HearnChristian/atmos-sense/README.md

# atmos-sense
Summer 2026 project to build familiarity with atmospheric sensor systems, drone integration, and all necessary concepts.
