HearnChristian/atmos-sense/firmware/ai/Atmos.pdf

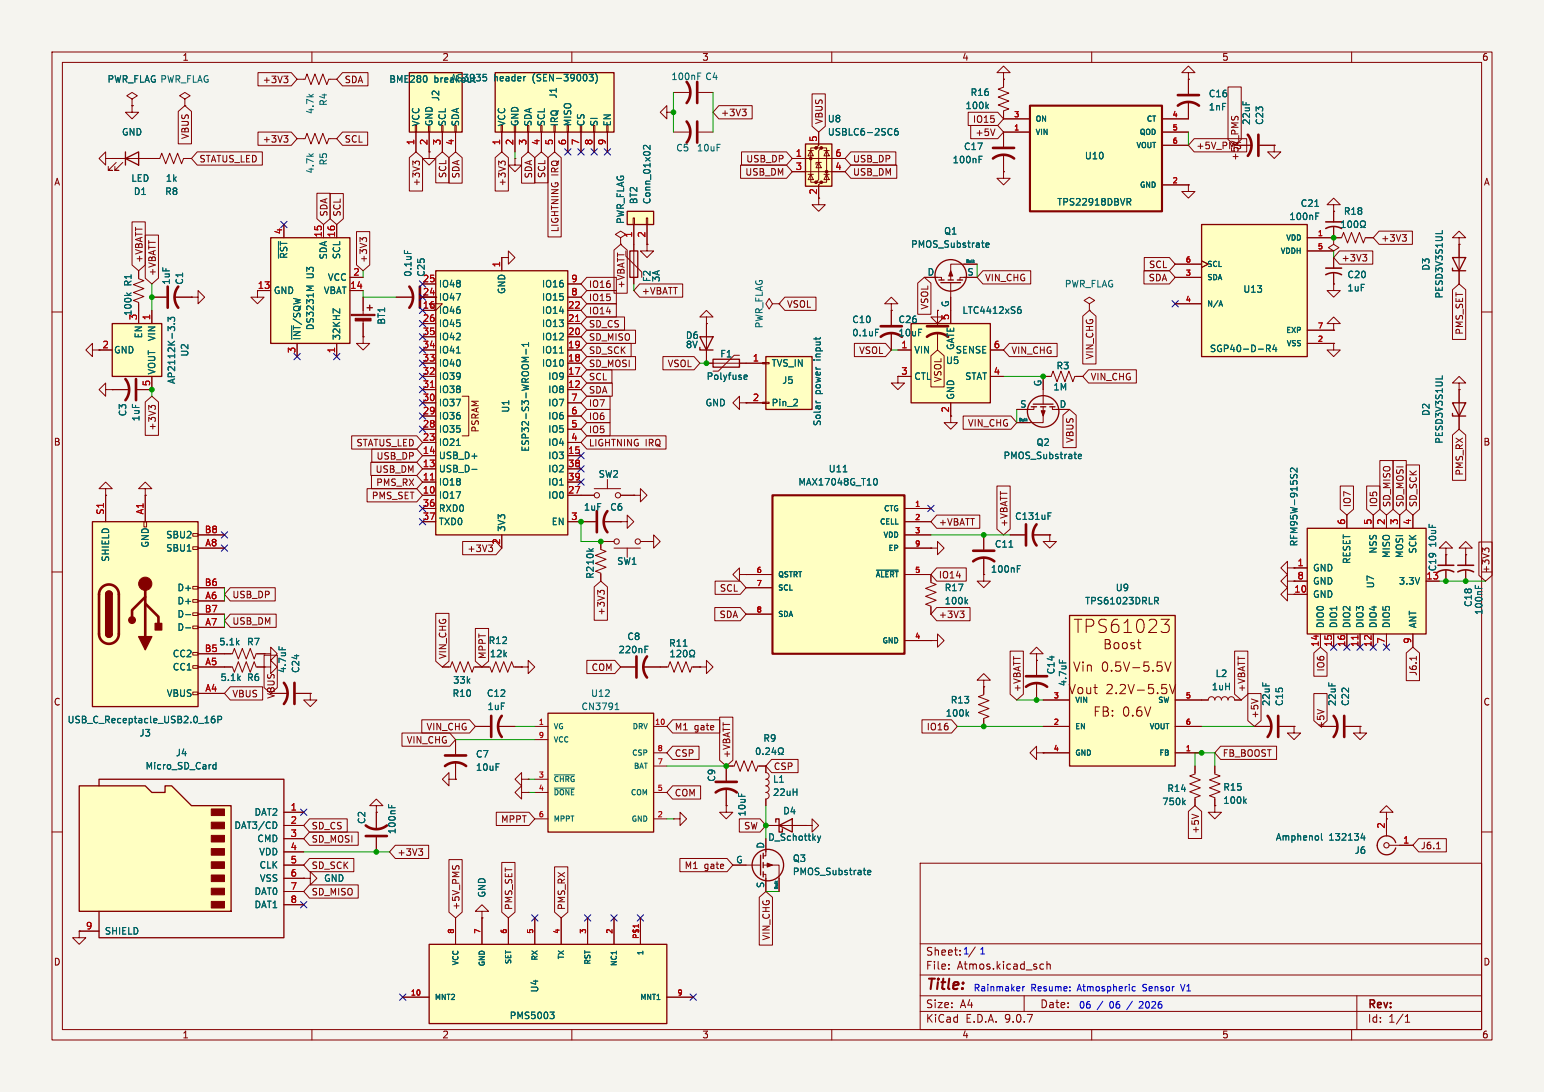
[picture p1: page 1]

Id: 1/1 Title: File: Atmos.kicad_sch Sheet: / C7
