HearnChristian/atmos-sense/firmware/ai/Atmos-pcb-routed.pdf

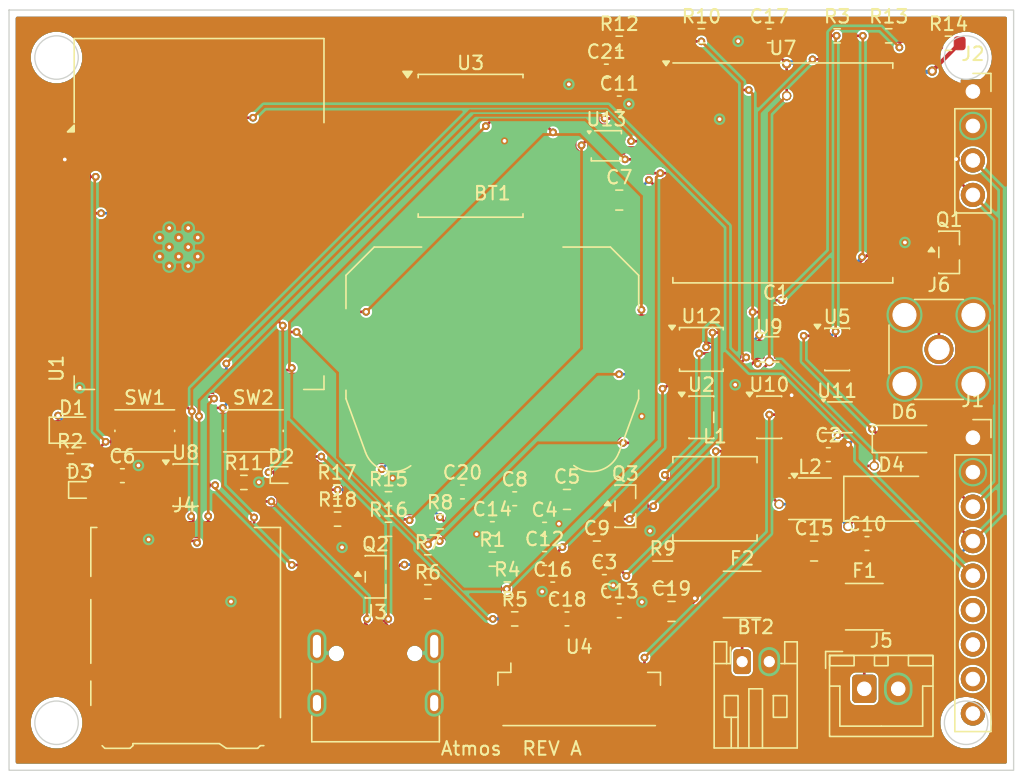
[picture p2: page 1]
