HearnChristian/atmos-sense/firmware/Atmos.kicad_pcb

## KiCad design firmware/Atmos.kicad_pcb (2026-07-20)

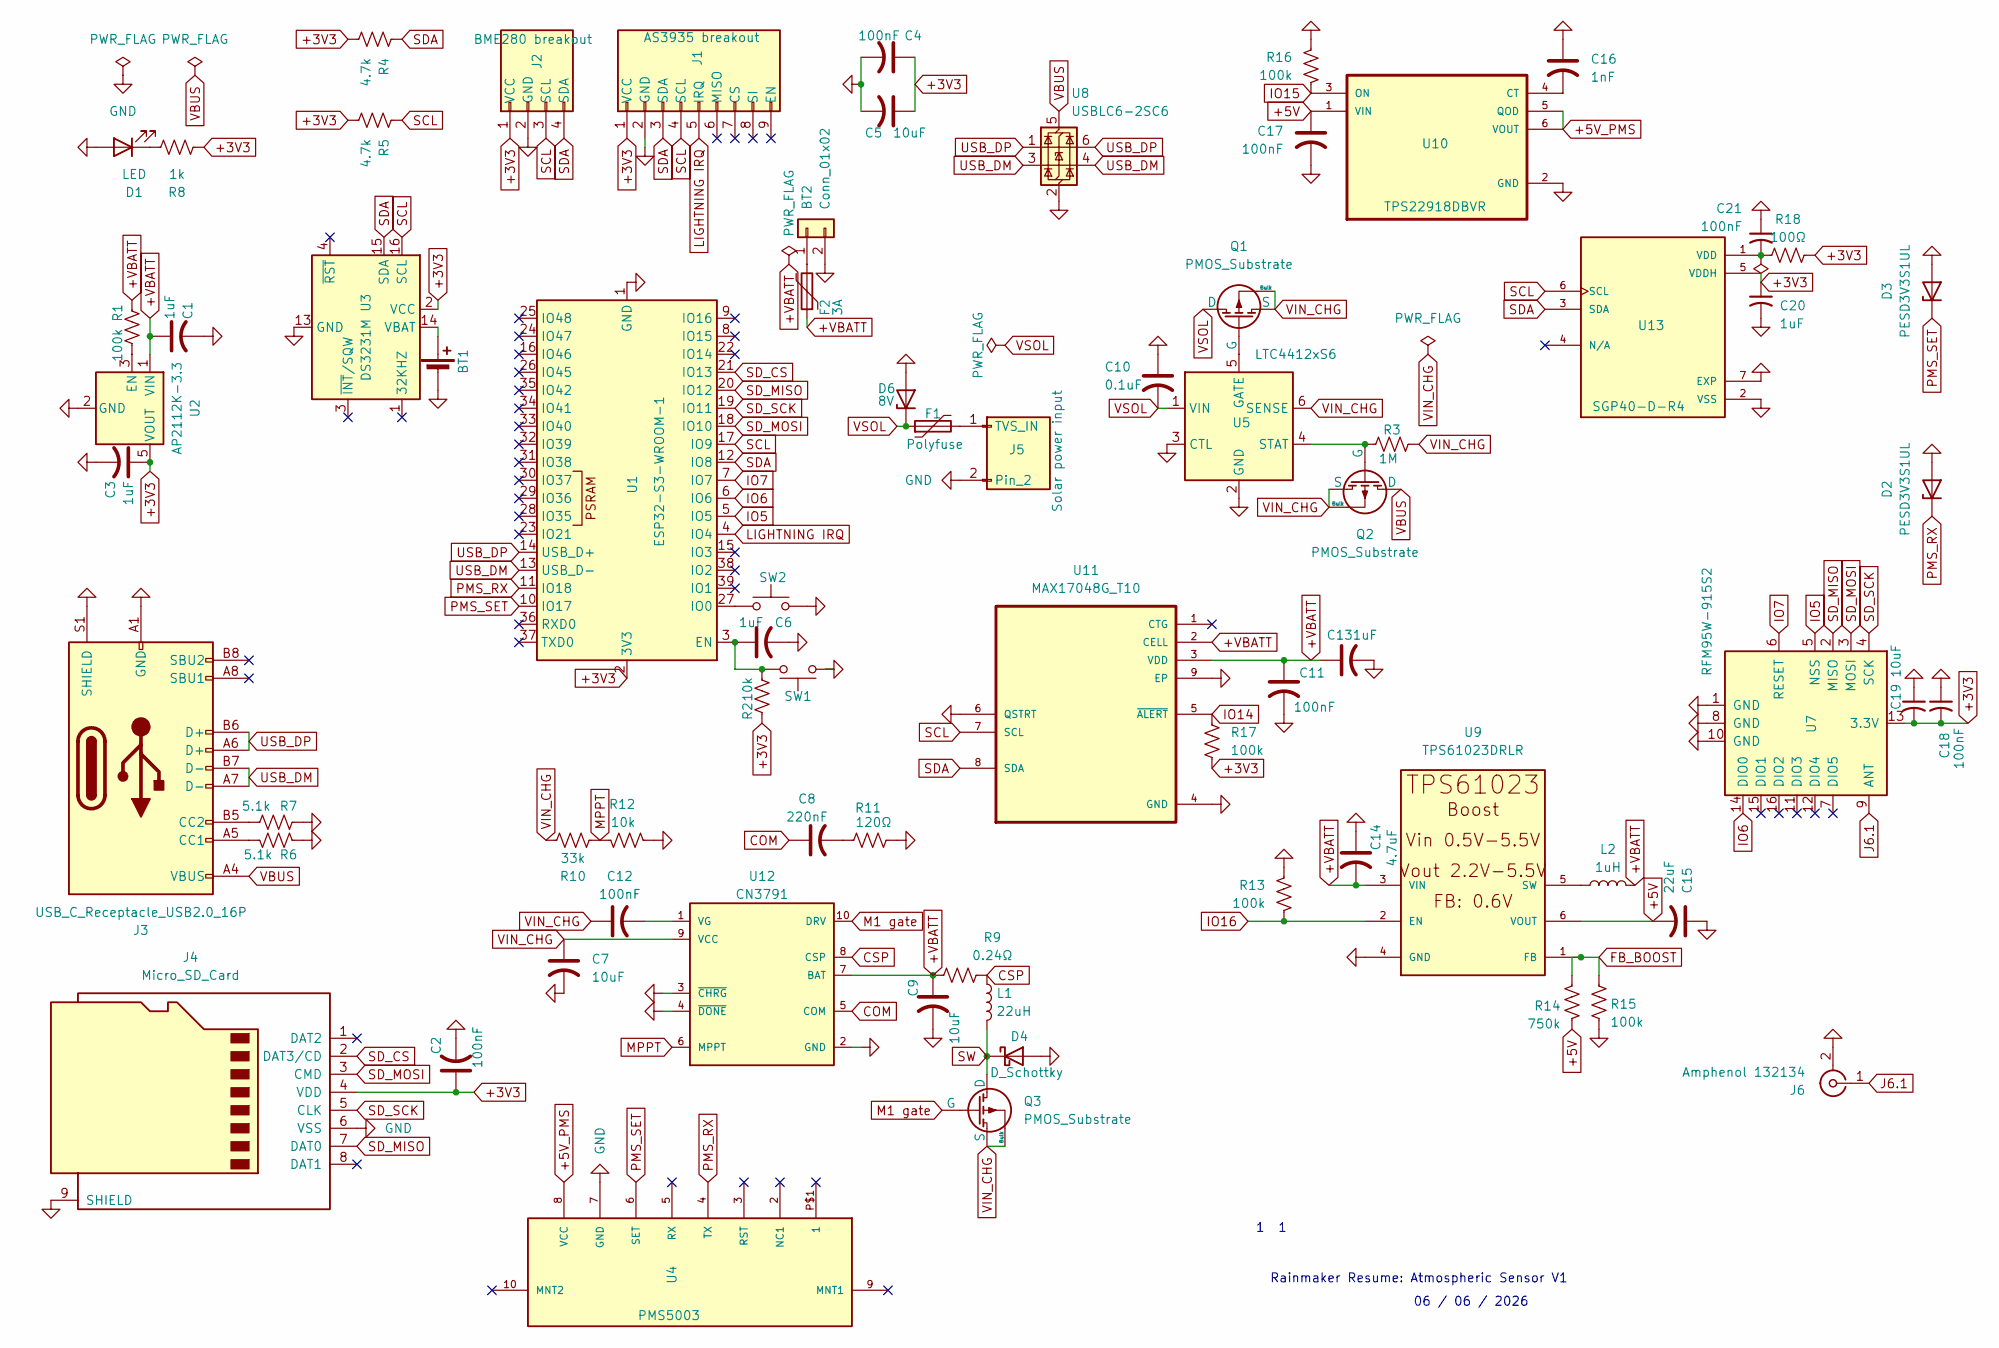
[picture p3: schematic Atmos.kicad_sch]

Parts:
BT1: Battery_Cell; BatteryHolder_Keystone_3034_1x20mm
BT2: Conn_01x02; JST_PH_S2B-PH-K_1x02_P2.00mm_Horizontal
C1, C3, C6, C13, C20: 1uF; C_0603_1608Metric
C2, C4, C11, C12, C17, C18, C21: 100nF; C_0603_1608Metric
C5, C7, C9, C19: 10uF; C_0805_2012Metric
C8: 220nF; C_0603_1608Metric
C10: 0.1uF; C_0603_1608Metric
C14: 4.7uF; C_0603_1608Metric
C15: 22uF; C_0805_2012Metric
C16: 1nF; C_0603_1608Metric
D1: LED; LED_0805_2012Metric
D2, D3: PESD3V3S1UL; D_SOD-882
D4: D_Schottky; D_SMA
D6: 8V; D_SOD-123
F1: Polyfuse; Fuse_1812_4532Metric
F2: 3A; Fuse_1812_4532Metric
J1: AS3935 breakout; PinSocket_1x09_P2.54mm_Vertical
J2: BME280 breakout; PinSocket_1x04_P2.54mm_Vertical
J3: USB_C_Receptacle_USB2.0_16P; USB_C_Receptacle_HRO_TYPE-C-31-M-12
J4: Micro_SD_Card; microSD_HC_Hirose_DM3AT-SF-PEJM5
J5: Solar power input; JST_XH_B2B-XH-A_1x02_P2.50mm_Vertical
J6: Amphenol 132134; SMA_Amphenol_132134_Vertical
L1: 22uH; L_Bourns_SRN6045TA
L2: 1uH; L_Coilcraft_1008HQ_2520Metric
Q1, Q2, Q3: PMOS_Substrate; SOT-23
R1, R13, R15, R16, R17: 100k; R_0603_1608Metric
R2, R12: 10k; R_0603_1608Metric
R3: 1M; R_0603_1608Metric
R4, R5: 4.7k; R_0603_1608Metric
R6, R7: 5.1k; R_0603_1608Metric
R8: 1k; R_0603_1608Metric
R9: 0.24Ω; R_1206_3216Metric
R10: 33k; R_0603_1608Metric
R11: 120Ω; R_0603_1608Metric
R14: 750k; R_0603_1608Metric
R18: 100Ω; R_0603_1608Metric
SW1: SW_Push_1P1T_NO_CK_KMR2
SW2: SW_Push; SW_Push_1P1T_NO_CK_KMR2
U1: ESP32-S3-WROOM-1
U2: AP2112K-3.3; SOT-23-5
U3: DS3231M; SOIC-16W_7.5x10.3mm_P1.27mm
U4: PMS5003; Molex_PicoBlade_53398-0871_1x08-1MP_P1.25mm_Vertical
U5: LTC4412xS6; TSOT-23-6
U7: RFM95W-915S2; HOPERF_RFM9XW_SMD
U8: USBLC6-2SC6; SOT-23-6
U9: TPS61023DRLR; SOT-563
U10: TPS22918DBVR; SOT-23-6
U11: MAX17048G_T10; DFN-8-1EP_2x2mm_P0.5mm_EP0.9x1.5mm
U12: CN3791; MSOP-10_3x3mm_P0.5mm
U13: SGP40-D-R4; DFN-6-1EP_2x2mm_P0.5mm_EP0.7x1.6mm; PARTREV 1.2

Connections:
+3V3: C2.1, C3.1, C4.1, C5.1, C18.2, C19.2, C20.1, J1.1 (VCC), J2.1 (VCC), J4.4 (VDD), R2.2, R4.2, R5.2, R8.1, R17.2, R18.2, U1.2 (3V3), U2.5 (VOUT), U3.2 (VCC), U7.13 (3.3V), U13.5 (VDDH)
+5V: C15.2, C17.1, R14.2, U9.6 (VOUT), U10.1 (VIN)
+5V_PMS: U4.8 (VCC), U10.5 (QOD), U10.6 (VOUT)
+VBATT: C1.1, C9.1, C11.1, C13.1, C14.2, F2.1, L2.2, R1.1, R9.1, U2.1 (VIN), U9.3 (VIN), U11.2 (CELL), U11.3 (VDD), U12.7 (BAT)
COM: C8.1, U12.5 (COM)
CSP: L1.1, R9.2, U12.8 (CSP)
FB_BOOST: R14.1, R15.1, U9.1 (FB)
GND: BT1.2 (-), BT2.2, C1.2, C2.2, C3.2, C4.2, C5.2, C6.2, C7.2, C9.2, C10.1, C11.2, C13.2, C14.1, C15.1, C16.1, C17.2, C18.1, C19.1, C20.2, C21.1, D1.2 (A), D2.2 (A), D3.2 (A), D4.2 (A), D6.2 (A), J1.2 (GND), J2.2 (GND), J3.A1 (GND), J3.A12 (GND), J3.B1 (GND), J3.B12 (GND), J3.S1 (SHIELD), J4.6 (VSS), J4.9 (SHIELD), J5.2, J6.2 (Ext), R6.2, R7.2, R11.2, R12.2, R13.1, R15.2, R16.1, SW1.1, SW2.2, U1.1 (GND), U1.40 (GND), U1.41 (GND), U2.2 (GND), U3.5 (GND), U3.6 (GND), U3.7 (GND), U3.8 (GND), U3.9 (GND), U3.10 (GND), U3.11 (GND), U3.12 (GND), U3.13 (GND), U4.7 (GND), U5.2 (GND), U5.3 (CTL), U7.1 (GND), U7.8 (GND), U7.10 (GND), U8.2 (GND), U9.4 (GND), U10.2 (GND), U11.4 (GND), U11.6 (QSTRT), U11.9 (EP), U12.2 (GND), U12.3 (~CHRG), U12.4 (~DONE), U13.2 (VSS), U13.7 (EXP)
IO5: U1.5 (IO5), U7.5 (NSS)
IO6: U1.6 (IO6), U7.14 (DIO0)
IO7: U1.7 (IO7), U7.6 (RESET)
IO14: R17.1, U11.5 (~ALERT)
IO15: R16.2, U10.3 (ON)
IO16: R13.2, U9.2 (EN)
J6.1: J6.1 (In), U7.9 (ANT)
LIGHTNING IRQ: J1.5 (IRQ), U1.4 (IO4)
M1 gate: Q3.2 (G), U12.10 (DRV)
MPPT: R10.1, R12.1, U12.6 (MPPT)
unnamed: BT1.1 (+), U3.14 (VBAT)
unnamed: BT2.1, F2.2
unnamed: C8.2, R11.1
unnamed: D1.1 (K), R8.2
unnamed: J3.A5 (CC1), R6.1
unnamed: J3.B5 (CC2), R7.1
unnamed: F1.2, J5.1 (TVS_IN)
unnamed: Q1.2 (G), U5.5 (GATE)
unnamed: Q2.2 (G), R3.1, U5.4 (STAT)
unnamed: C6.1, R2.1, SW1.2, U1.3 (EN)
unnamed: SW2.1, U1.27 (IO0)
unnamed: R1.2, U2.3 (EN)
unnamed: L2.1, U9.5 (SW)
unnamed: C16.2, U10.4 (CT)
unnamed: C12.2, U12.1 (VG)
unnamed: C21.2, R18.1, U13.1 (VDD)
PMS_RX: D2.1 (K), U1.11 (IO18), U4.4 (TX)
PMS_SET: D3.1 (K), U1.10 (IO17), U4.6 (SET)
SCL: J1.4 (SCL), J2.3 (SCL), R5.1, U1.17 (IO9), U3.16 (SCL), U11.7 (SCL), U13.6 (SCL)
SDA: J1.3 (SDA), J2.4 (SDA), R4.1, U1.12 (IO8), U3.15 (SDA), U11.8 (SDA), U13.3 (SDA)
SD_CS: J4.2 (DAT3/CD), U1.21 (IO13)
SD_MISO: J4.7 (DAT0), U1.20 (IO12), U7.2 (MISO)
SD_MOSI: J4.3 (CMD), U1.18 (IO10), U7.3 (MOSI)
SD_SCK: J4.5 (CLK), U1.19 (IO11), U7.4 (SCK)
SW: D4.1 (K), L1.2, Q3.1 (D)
USB_DM: J3.A7 (D-), J3.B7 (D-), U1.13 (USB_D-), U8.3 (I/O2), U8.4 (I/O2)
USB_DP: J3.A6 (D+), J3.B6 (D+), U1.14 (USB_D+), U8.1 (I/O1), U8.6 (I/O1)
VBUS: J3.A4 (VBUS), J3.A9 (VBUS), J3.B4 (VBUS), J3.B9 (VBUS), Q2.1 (D), U8.5 (VBUS)
VIN_CHG: C7.1, C12.1, Q1.3 (S), Q1.4 (Bulk), Q2.3 (S), Q2.4 (Bulk), Q3.3 (S), Q3.4 (Bulk), R3.2, R10.2, U5.6 (SENSE), U12.9 (VCC)
VSOL: C10.2, D6.1 (K), F1.1, Q1.1 (D), U5.1 (VIN)

Notes on the sheet:
06 / 06 / 2026
1 1
Rainmaker Resume: Atmospheric Sensor V1

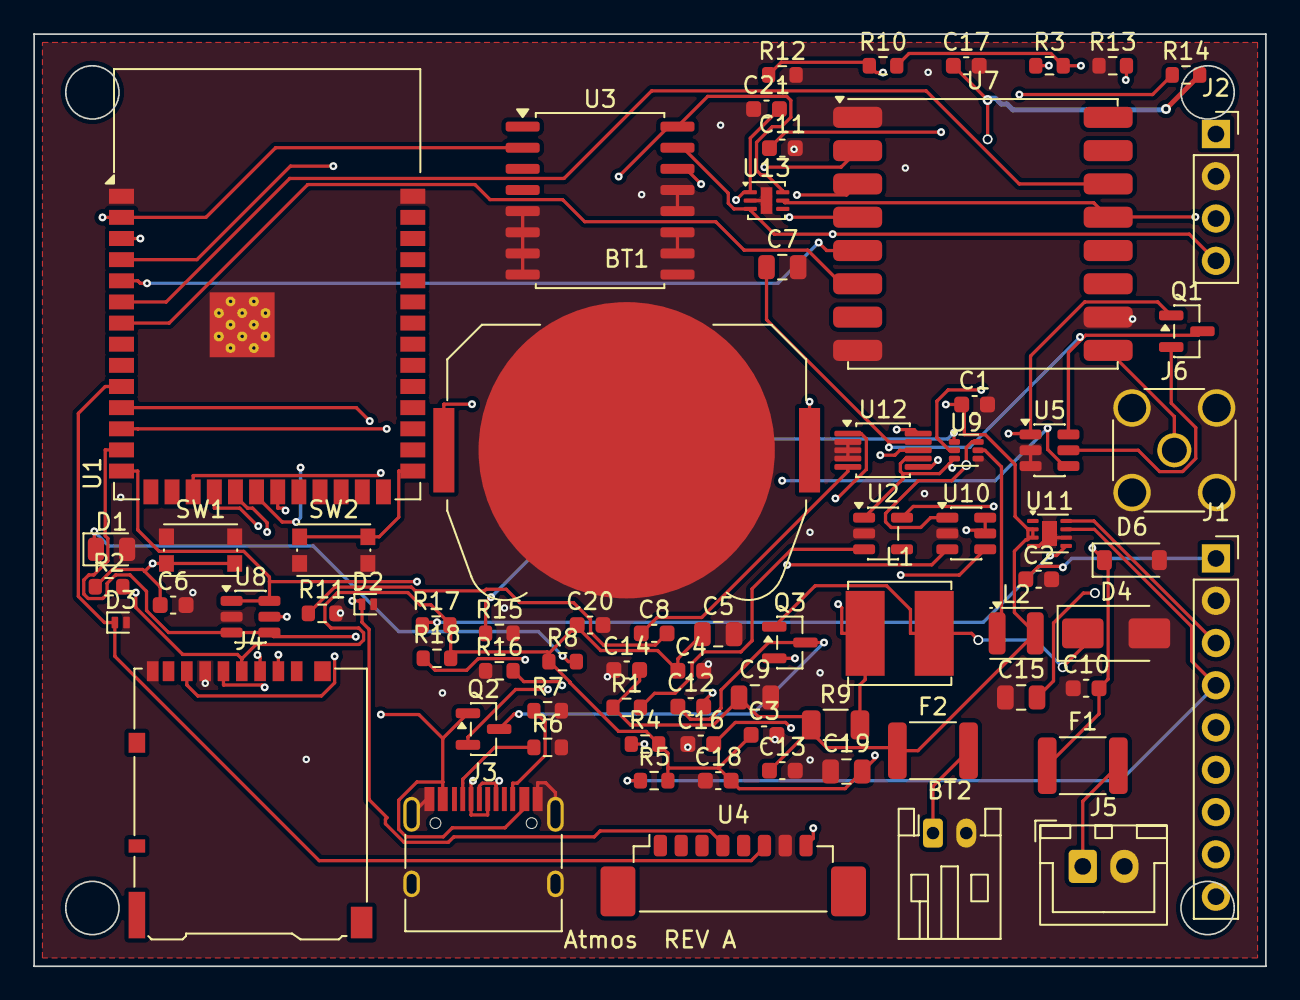
[picture p4: board Atmos.kicad_pcb from above]

Board: 4 copper layers, 74.0 x 56.0 mm, 73 parts (0 on the bottom side), 48 nets.
