HearnChristian/atmos-sense/(commit log)

2026-05-31 Add v1 firmware and Wokwi simulation setup
    ESP32 sketch with WOKWI_SIMULATION toggle; mocks BME280, AS3935, and SD
    in software (no Custom Chips needed). Includes diagram.json (bare ESP32
    DevKit V1) and libraries.txt for Wokwi web simulator.
2026-06-02 Add files via upload
    V1 schematic
    [Atmos_sense.kicad_sch]
2026-06-06 Add files via upload
    Expanded version of V1
    [Atmos.kicad_sch]
2026-06-06 Sync latest schematic + add AI exports (PDF/netlist/BOM) for browser-Claude
    [Atmos-bom.csv, Atmos.kicad_sch]
2026-06-06 Remove stale root Atmos_sense.kicad_sch; firmware/Atmos.kicad_sch is canonical
    [Atmos_sense.kicad_sch]
2026-06-06 U5 LTC4412xS6 wired
    [Atmos-bom.csv, Atmos.kicad_sch]
2026-06-06 fixed U12 wiring
2026-06-07 wired J5 solar
    [Atmos-bom.csv, Atmos.kicad_sch]
2026-06-07 BT2 wired
    [Atmos.kicad_sch]
2026-06-07 U11 wired
    [Atmos-bom.csv, Atmos.kicad_sch]
2026-06-07 U11 touchup
    [Atmos-bom.csv, Atmos.kicad_sch]
2026-06-07 TPS init
    [Atmos-bom.csv, Atmos.kicad_sch]
2026-06-07 TPS progress
    [Atmos-bom.csv, Atmos.kicad_sch]
2026-06-07 TPS finished
    [Atmos-bom.csv, Atmos.kicad_sch]
2026-06-07 RF component + Antenna
    [Atmos-bom.csv, Atmos.kicad_sch]
2026-06-07 USBLC6 done
    [Atmos-bom.csv, Atmos.kicad_sch]
2026-06-07 added diodes
2026-06-07 Schematic tentatively finished
    [Atmos-bom.csv, Atmos.kicad_sch]
2026-06-07 Schematic fully finished -hierarchies
    [Atmos-bom.csv, Atmos.kicad_sch]
2026-06-10 updated a few values
    [Atmos-bom.csv, Atmos.kicad_sch]
2026-07-13 Add PCB pre-layout plan: stackup trade, floorplan proposal, footprint blockers
2026-07-13 PCB plan: ratify stackup/floorplan, record connector decisions
2026-07-13 J6: specify SMA jack (Amphenol 132134) for LoRa antenna
    [Atmos-bom.csv, Atmos.kicad_sch]
2026-07-13 Add bring-up shopping BOM (remaining hardware vs owned inventory)
2026-07-15 PCB V1: footprint pass, 4-layer board generation, plane+signal routing
    Generated the first Atmos PCB from the schematic with a pcbnew-driven
    toolchain (tools/board_gen -> route_maze -> route_planes).
    - Footprint pass: assigned all 60 unassigned parts; found and remapped 6
    dangling IC footprint refs (missing vendor .kicad_mod) to std-lib
    equivalents by package (see docs/PCB-V1-NOTES.md).
    - 4-layer FR4 (F.Cu / GND / +3V3 / B.Cu), 73 parts placed clean, radios in
    opposite corners, 4x M3 mounting holes.
    - Routing: GND + 3V3 planes, 17 signal nets, 0 shorts (~55% of ratsnest);
    spanning buses + secondary power left for interactive routing.
    - Board grew ratified 65x50 -> 74x56 (parts don't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
    [Atmos-bom.csv, Atmos.kicad_pcb, Atmos.kicad_sch]
2026-07-20 PCB V1: finish routing with Freerouting (~99.85%, solid GND plane)
    Completed the remaining ~45% of the board with Freerouting 2.2.4 (headless
    CLI, local JRE). From 55% -> ~99.85% routed (1 of ~660 connections open),
    0 shorts / 0 clearance / 0 hole-to-hole violations.
    - Stackup: F.Cu signal / In1 solid GND plane / In2 +3V3+power+signal / B.Cu
    signal. Freeing In2 as a routing layer (vs locking both inner planes) was
    the key to a completable route.
    - F.Cu GND pour stitched to the In1 plane with all-layer/hole/edge-aware vias.
    - min_via_diameter 0.5 -> 0.4 mm (Freerouting emits 0.48 mm vias).
    - 1 open connection: U13 (SGP40) GND, blocked by the placeholder DFN
    footprint; resolves when the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
    [Atmos.kicad_pcb]
2026-07-20 Full design review: 3 critical pre-fab bugs + ranked findings
    Netlist-level audit (components -> footprints -> wiring). Critical: ESP32
    IO14/15/16 labels never attached (boost EN floating = +5V dead), D1 LED
    reversed, PMS5003 connector pin order mirrored vs Plantower (verify harness).
    Plus L2 RF-inductor swap, MPPT floor vs USB charging, and the known footprint
    placeholders. Power path, buses, straps all verified correct pin-by-pin.
2026-07-20 Add bench bring-up firmware (previously local-only, unbacked-up)
    ESP32-S3 sketches validating sense->timestamp->log->deep-sleep on real
    hardware (BME280, DS3231, microSD), steps 1-4 complete 2026-07-19. These
    lived only in ~/Arduino/ with no backup; firmware/v1/sketch.ino is an
    older, unrelated Wokwi-simulation draft. Includes a repo-portable copy of
    atmos-flash.sh (resolves sketch paths relative to itself instead of
    ~/Arduino).
    [01_bringup.ino, 02_i2c_scan.ino, 02b_sensor_read.ino, 03_sd_test.ino, 03b_sd_probe.ino, 04_atmos_node.ino, 04_sd_softspi.ino]
2026-07-20 Cap fixes: C12 VG 1uF, +5V 2nd 22uF (C22), +5V_PMS bulk (C23), VBUS/VBAT/VSOL bulk
    [Atmos-bom.csv, Atmos.kicad_sch]
2026-07-22 BOM: specify Playing With Fusion SEN-39003 for AS3935 (J1); avoid Amazon clones
    [Atmos-bom.csv, Atmos.kicad_sch]
